uf-cpe-design-lab/kagu/prototype/drawing-sheet/out/layout/layout.pdf

# KAGU · INSTRUMENT CABINET — CHOSEN LAYOUT: 40" TALL · 600 mm DEEP · SPACED (1:8)

Two Rigol sets side by side in the low bay; drawers above. Dimensions in mm (inches). Drawer heights in gridfinity units (U = 7 mm).

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
72 (2.9") | 6U sensors, boxed boards | 12×10 / 12×12
72 (2.9") | 6U sensors, boxed boards | 12×10 / 12×12
72 (2.9") | 6U sensors, boxed boards | 12×10 / 12×12
72 (2.9") | 6U sensors, boxed boards | 12×10 / 12×12
72 (2.9") | 6U sensors, boxed boards | 12×10 / 12×12
72 (2.9") | 6U sensors, boxed boards | 12×10 / 12×12
72 (2.9") | 6U sensors, boxed boards | 12×10 / 12×12
10U stacked boxes, tools | 12×10 / 12×12 | 103 (4.1")
10U stacked boxes, tools | 12×10 / 12×12 | 103 (4.1")
6U sensors, boxed boards | 12×10 / 12×12 | 75 (3.0")
6U sensors, boxed boards | 12×10 / 12×12 | 75 (3.0")
6U sensors, boxed boards | 12×10 / 12×12 | 75 (3.0")
6U sensors, boxed boards | 12×10 / 12×12 | 75 (3.0")

worktop 1016 (40")

fence 1091 (43.0")

bay 300 (11.8")

1200 (47.2")

# 40" · SPACED — FRONT — 13 DRAWERS

spare height shared out as taller fronts · drawers 12 + 12 units wide × 10 deep (500) / 12 deep (600)

worktop (between the sides)

2 printed M6 handles per side, 180 mm centres (Emkatech, CC BY-NC)

printed wall standoffs 50 (2"): PETG cone + TPU cap

600 (23.6")

worktop 1016 (40")

fence +75 (3")

R50 (2.0")

FRONT

# RIGHT SIDE

BACK

### sides + back rise above the worktop; only the front corner is rounded

Pitch per drawer = bottom 12 + baseplate 5 + bin 7·U + lip 4.4 + clearance 4 + gap 3: 3U ≈ 49 (1.9") · 4U ≈ 56 (2.2") · 6U ≈ 70 (2.8") · 10U ≈ 98 (3.9").
6U: sensors (several per bin) and boxed boards one layer deep (3×2 bins, e.g. Raspberry Pi 5 boxes). 10U: boxed boards stacked two high, hand tools in Shadow Bins. Depth: 500 mm (19.7") → 18" slides, drawers 12 × 10 units; 600 mm (23.6") → 22" slides, 12 × 12 units (+20%). Drawers 12 units (21") wide on standard 1/2" slides.
