uf-cpe-design-lab/kagu/prototype/drawing-sheet/out/layout/layout.png

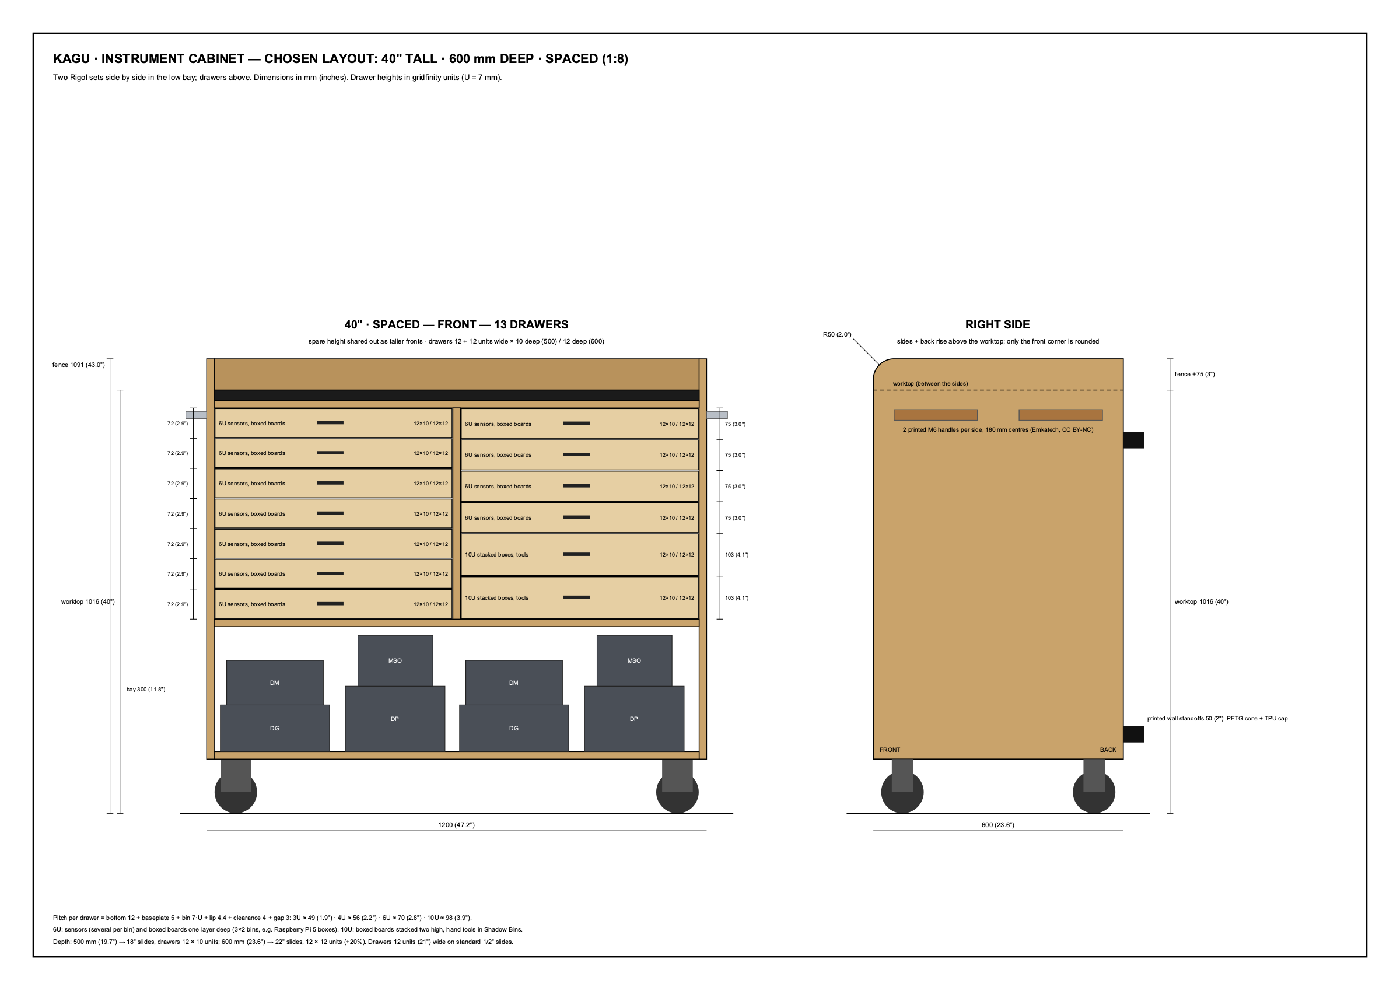
prototype/drawing-sheet/out/layout/layout.png
