uf-cpe-design-lab/kagu/prototype/drawing-sheet/out/layout/pull_preview.png

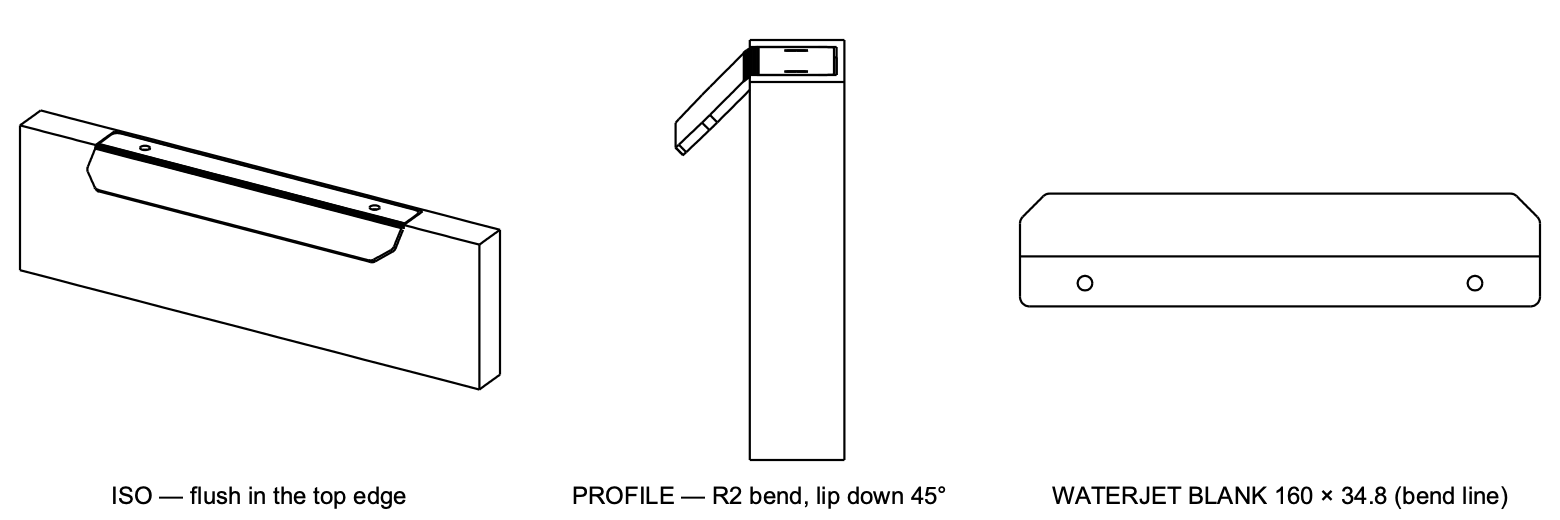
prototype/drawing-sheet/out/layout/pull_preview.png
