uf-cpe-design-lab/kagu/prototype/drawing-sheet/out/sheet1_notation.png

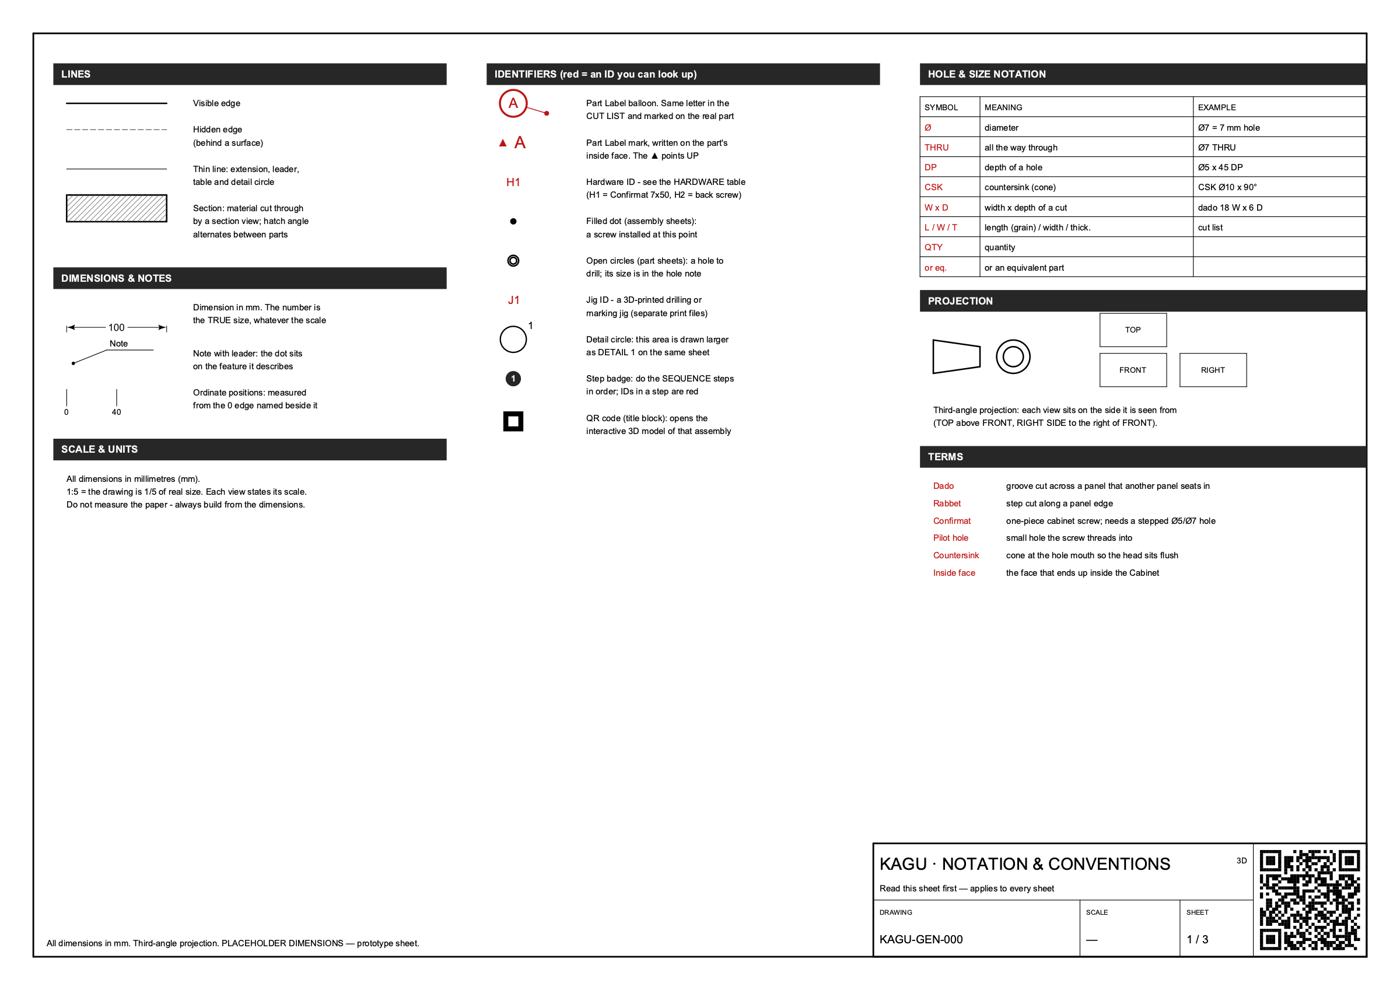
prototype/drawing-sheet/out/sheet1_notation.png
