uf-cpe-design-lab/kagu/prototype/drawing-sheet/out/sheet3_part_A.png

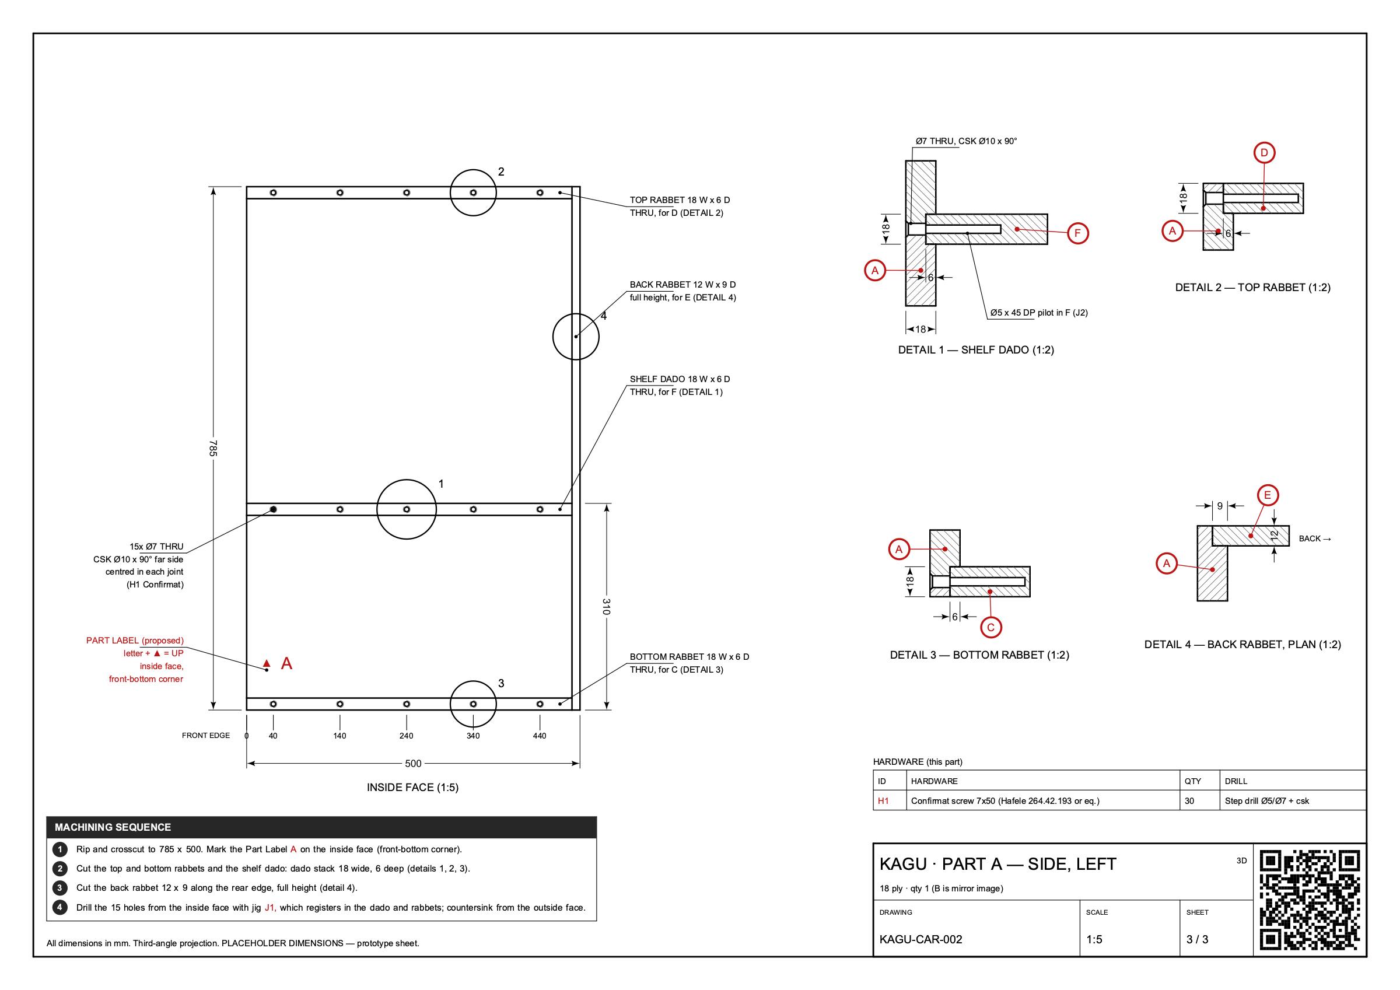
prototype/drawing-sheet/out/sheet3_part_A.png
