uf-cpe-design-lab/kagu/prototype/drawing-sheet/out/print/drawer_pull_flat_5052_2mm_waterjet.dxf

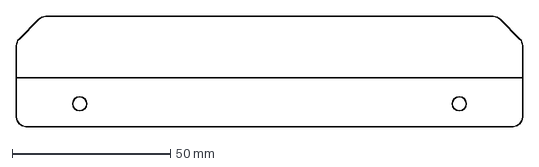
[picture p5: CAD file, 2026-11-09]
prototype/drawing-sheet/out/print/drawer_pull_flat_5052_2mm_waterjet.dxf
160.0 x 34.8 mm
