uf-cpe-design-lab/kagu/prototype/drawing-sheet/out/print/standoff_base_PETG.stl

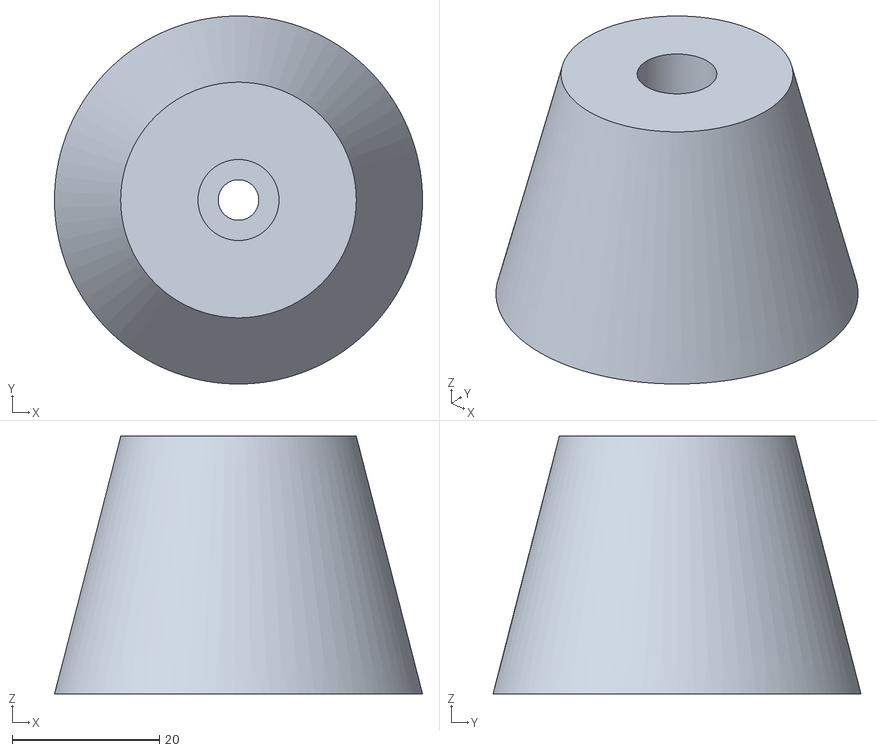
[picture p7: CAD file, 2026-11-09]
prototype/drawing-sheet/out/print/standoff_base_PETG.stl
50.0 x 50.0 x 35.0
