uf-cpe-design-lab/kagu/prototype/drawing-sheet/out/print/bin_1x1_6U_sensor.stl

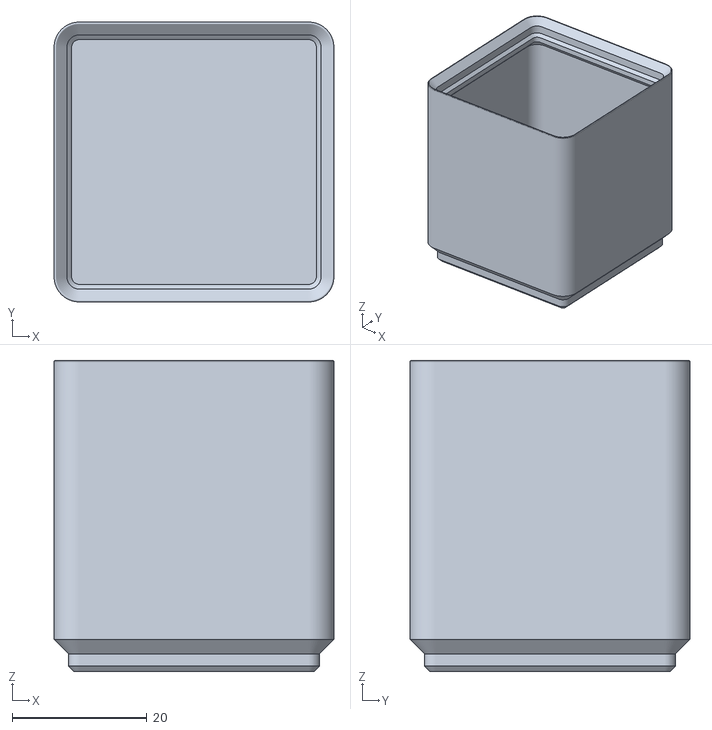
[picture p8: CAD file, 2026-11-09]
prototype/drawing-sheet/out/print/bin_1x1_6U_sensor.stl
41.5 x 41.5 x 46.1
