uf-cpe-design-lab/kagu/prototype/drawing-sheet/out/print/bin_3x2_10U_pi-box-stack.stl

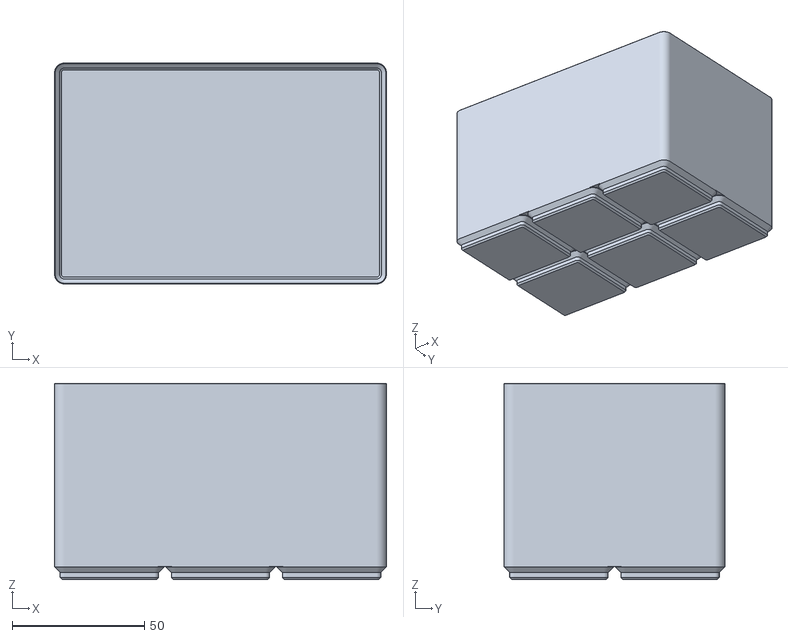
[picture p9: CAD file, 2026-11-09]
prototype/drawing-sheet/out/print/bin_3x2_10U_pi-box-stack.stl
125.5 x 83.5 x 74.1
