uf-cpe-design-lab/kagu/prototype/drawing-sheet/out/print/bin_3x2_6U_pi-box.stl

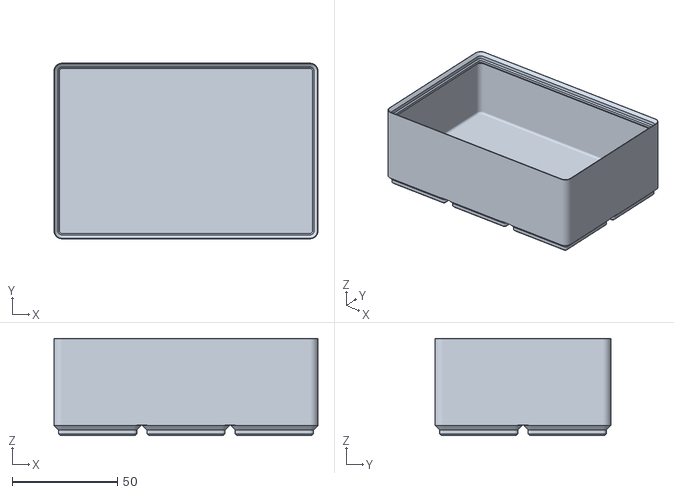
[picture p10: CAD file, 2026-11-09]
prototype/drawing-sheet/out/print/bin_3x2_6U_pi-box.stl
125.5 x 83.5 x 46.1
