uf-cpe-design-lab/kagu/prototype/drawing-sheet/out/print/handle_300_PETG.stl

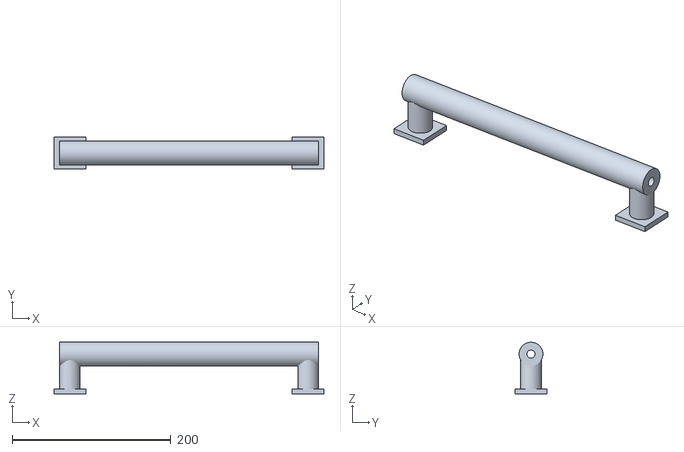
[picture p11: CAD file, 2026-11-09]
prototype/drawing-sheet/out/print/handle_300_PETG.stl
340.0 x 40.0 x 65.0
