uf-cpe-design-lab/kagu/prototype/drawing-sheet/out/print/bin_2x2_6U_sensor.stl

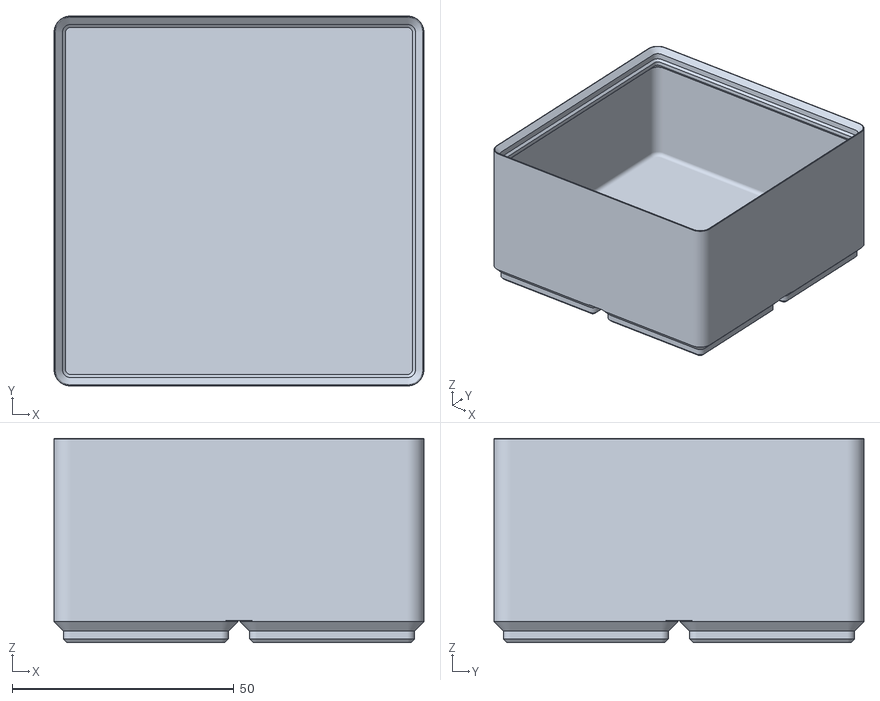
[picture p12: CAD file, 2026-11-09]
prototype/drawing-sheet/out/print/bin_2x2_6U_sensor.stl
83.5 x 83.5 x 46.1
