uf-cpe-design-lab/kagu/prototype/drawing-sheet/out/print/drawer_pull_ref.stl

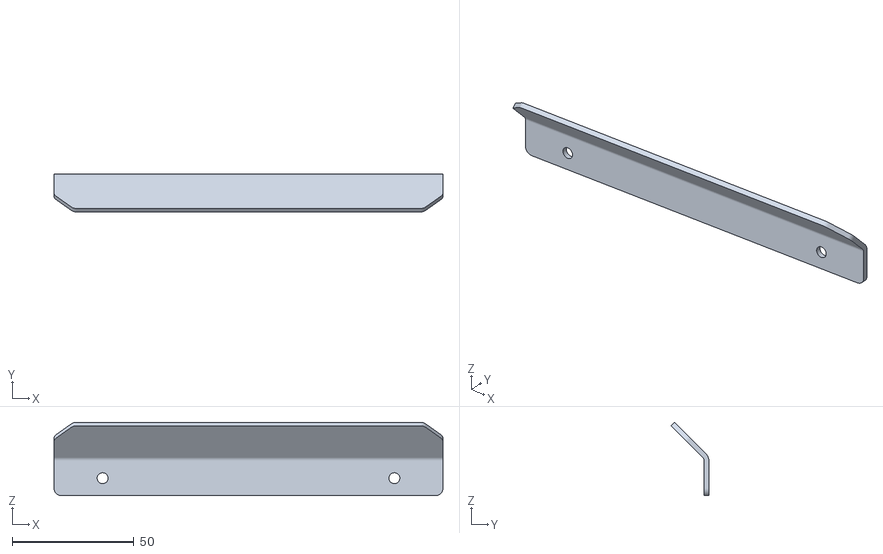
[picture p13: CAD file, 2026-11-09]
prototype/drawing-sheet/out/print/drawer_pull_ref.stl
160.0 x 15.6 x 30.1
