uf-cpe-design-lab/kagu/prototype/drawing-sheet/out/print/baseplate_5x2.stl

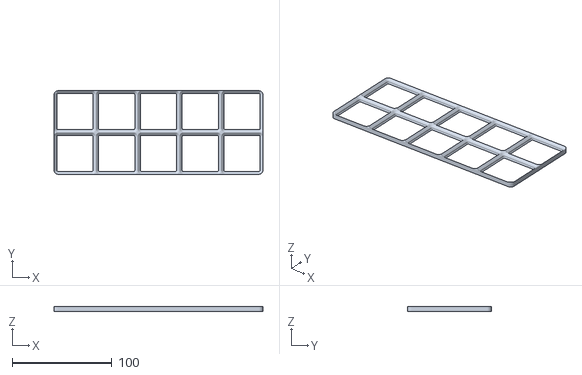
[picture p14: CAD file, 2026-11-09]
prototype/drawing-sheet/out/print/baseplate_5x2.stl
210.0 x 84.0 x 4.65
