uf-cpe-design-lab/kagu/prototype/drawing-sheet/out/print/standoff_cap_TPU.stl

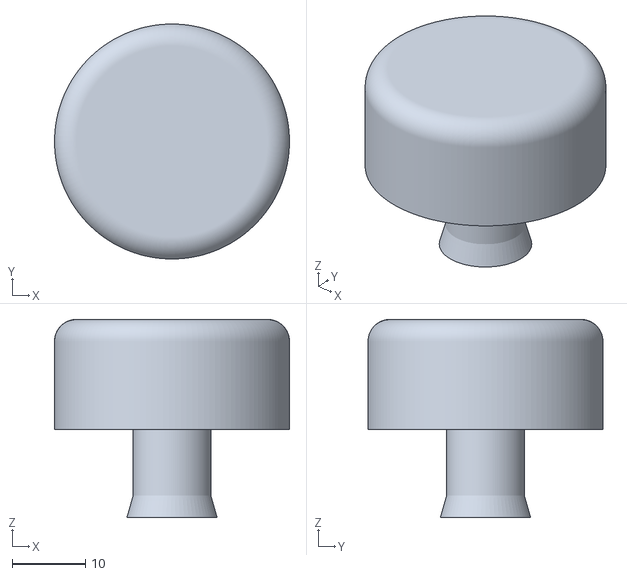
[picture p15: CAD file, 2026-11-09]
prototype/drawing-sheet/out/print/standoff_cap_TPU.stl
32.0 x 32.0 x 27.0
