uf-cpe-design-lab/kagu/prototype/drawing-sheet/out/print/bin_2x1_3U_flat.stl

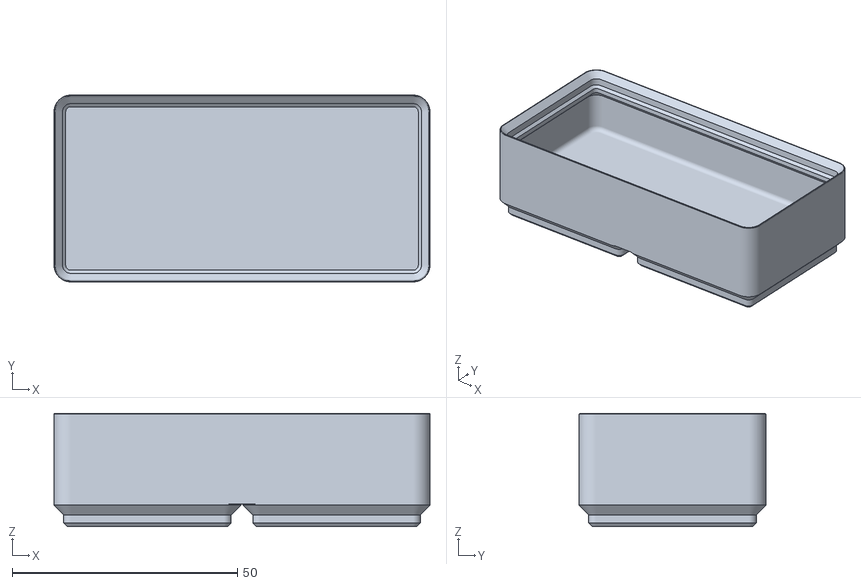
[picture p16: CAD file, 2026-11-09]
prototype/drawing-sheet/out/print/bin_2x1_3U_flat.stl
83.5 x 41.5 x 25.1
