uf-cpe-design-lab/kagu/prototype/drawing-sheet/out/sheet2_assembly.png

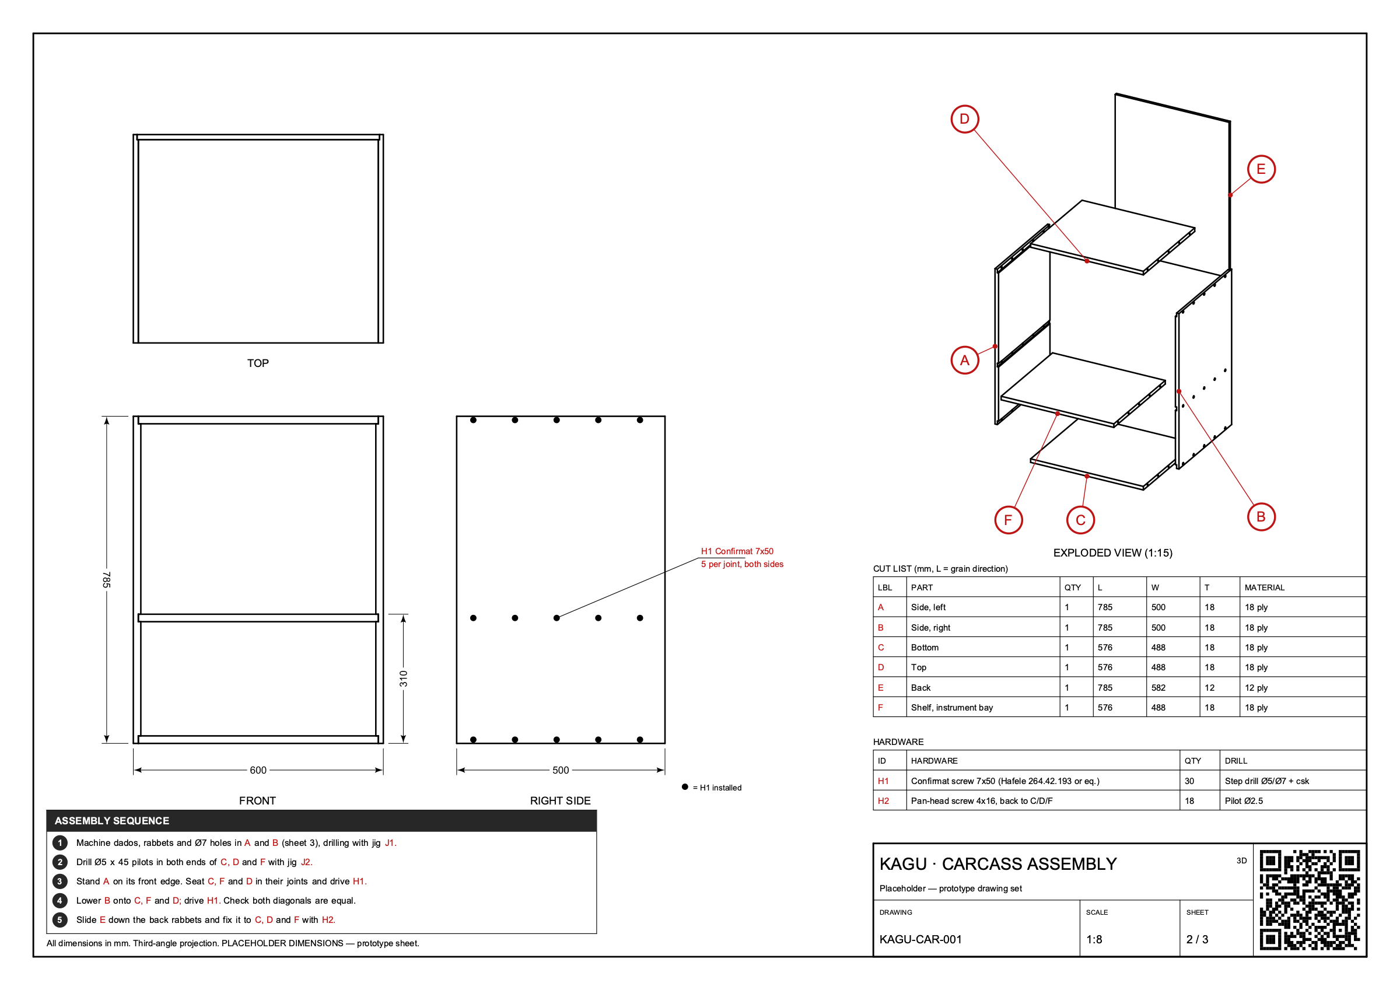
prototype/drawing-sheet/out/sheet2_assembly.png
