uf-cpe-design-lab/kagu/prototype/drawing-sheet/out/carcass_set.pdf

# KAGU · NOTATION & CONVENTIONS 3D Read this sheet first — applies to every sheet

DRAWING KAGU-GEN-000 | SCALE — | SHEET

All dimensions in mm. Third-angle projection. PLACEHOLDER DIMENSIONS — prototype sheet.

### LINES

Visible edge

Hidden edge
(behind a surface)

Thin line: extension, leader, table and detail circle

Section: material cut through by a section view; hatch angle alternates between parts

### DIMENSIONS & NOTES

Dimension in mm. The number is the TRUE size, whatever the scale

Note
Note with leader: the dot sits
on the feature it describes
0 | 40

Ordinate positions: measured from the 0 edge named beside it

### SCALE & UNITS

All dimensions in millimetres (mm).
1:5 = the drawing is 1/5 of real size. Each view states its scale. Do not measure the paper - always build from the dimensions.

### IDENTIFIERS (red = an ID you can look up)

A | Part Label balloon. Same letter in the CUT LIST and marked on the real part
▲ A | Part Label mark, written on the part's inside face. The ▲ points UP
H1 | Hardware ID - see the HARDWARE table (H1 = Confirmat 7x50, H2 = back screw)
| Filled dot (assembly sheets): a screw installed at this point
| Open circles (part sheets): a hole to drill; its size is in the hole note
J1 | Jig ID - a 3D-printed drilling or marking jig (separate print files)

1
| Detail circle: this area is drawn larger as DETAIL 1 on the same sheet

### 1 Step badge: do the SEQUENCE steps

| in order; IDs in a step are red
| QR code (title block): opens the interactive 3D model of that assembly

### HOLE & SIZE NOTATION

SYMBOL | MEANING | EXAMPLE
Ø | diameter | Ø7 = 7 mm hole
THRU | all the way through | Ø7 THRU
DP | depth of a hole | Ø5 x 45 DP
CSK | countersink (cone) | CSK Ø10 x 90°
W x D | width x depth of a cut | dado 18 W x 6 D
L / W / T | length (grain) / width / thick. | cut list
QTY | quantity
or eq. | or an equivalent part

### PROJECTION

FRONT

TOP

RIGHT

Third-angle projection: each view sits on the side it is seen from (TOP above FRONT, RIGHT SIDE to the right of FRONT).

### TERMS

Dado | groove cut across a panel that another panel seats in
Rabbet | step cut along a panel edge
Confirmat | one-piece cabinet screw; needs a stepped Ø5/Ø7 hole
Pilot hole | small hole the screw threads into
Countersink | cone at the hole mouth so the head sits flush
Inside face | the face that ends up inside the Cabinet

D

E

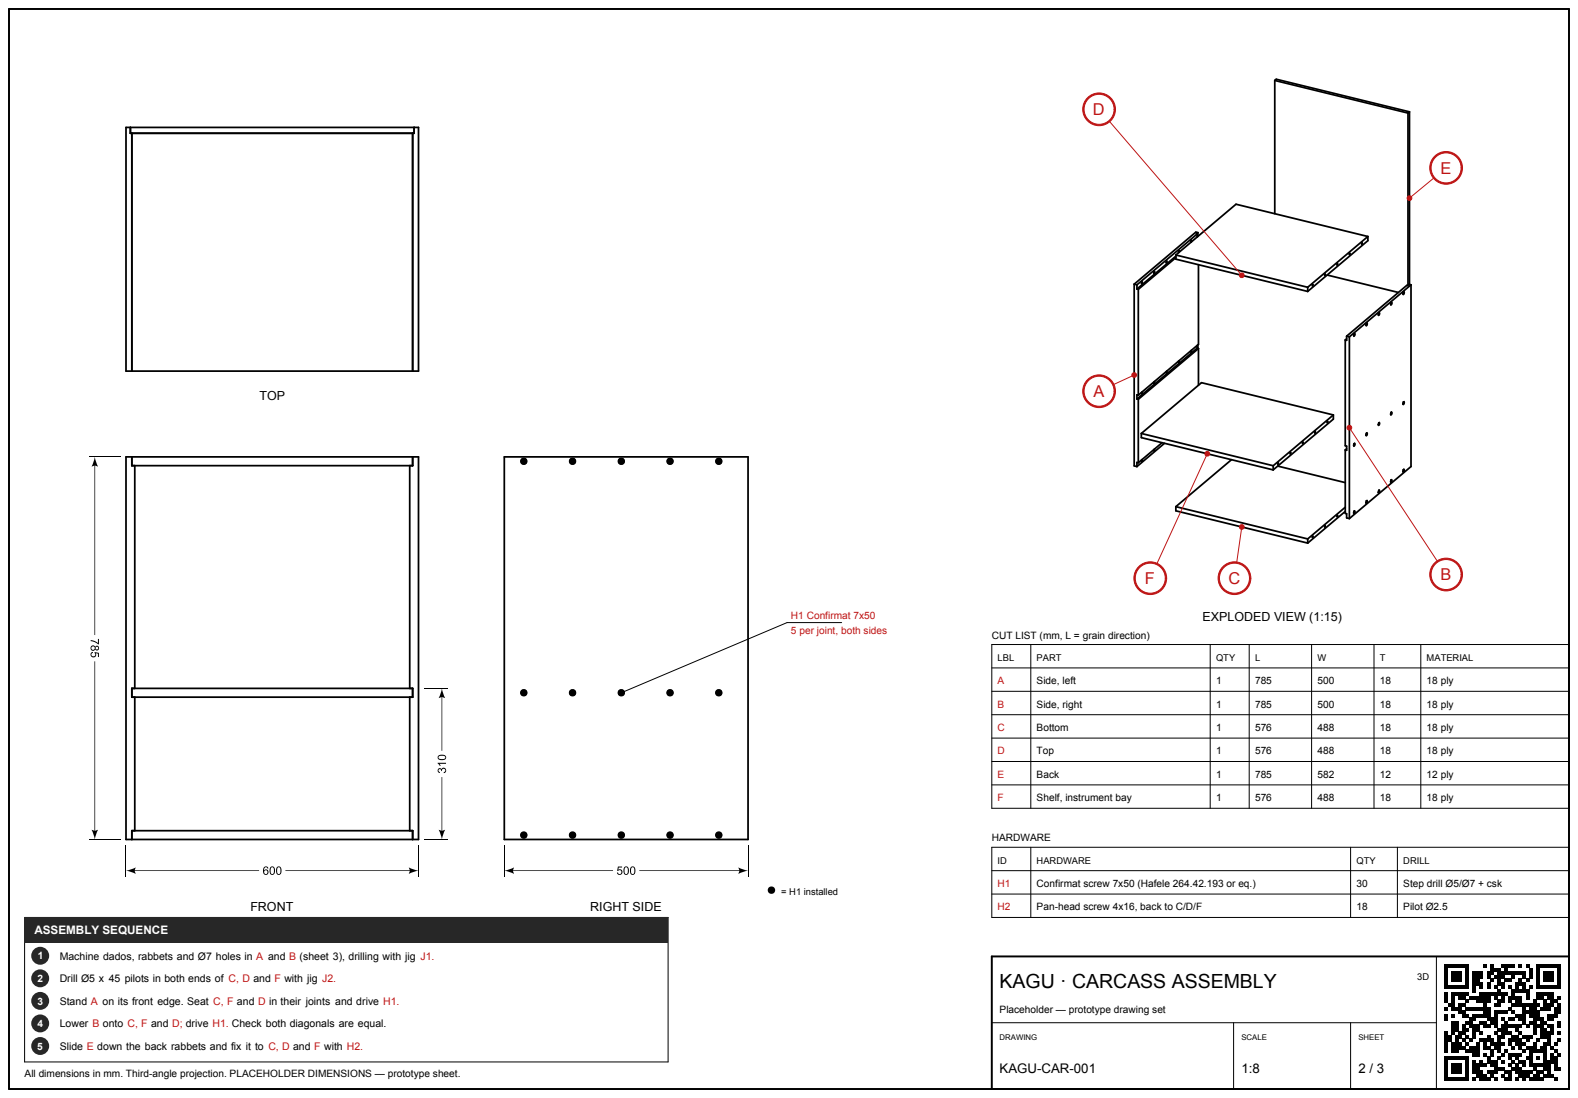
[picture p18: page 2]
FRONT; RIGHT SIDE; TOP; = H1 installed; EXPLODED VIEW (1:15); HARDWARE; ASSEMBLY SEQUENCE

H1 Confirmat 7x50
5 per joint, both sides

CUT LIST (mm, L = grain direction)

LBL | PART | QTY | L | W | T | MATERIAL

A | Side, left | 1 | 785 | 500 | 18 | 18 ply

B | Side, right | 1 | 785 | 500 | 18 | 18 ply

C | Bottom | 1 | 576 | 488 | 18 | 18 ply

D | Top | 1 | 576 | 488 | 18 | 18 ply

E | Back | 1 | 785 | 582 | 12 | 12 ply

F | Shelf, instrument bay | 1 | 576 | 488 | 18 | 18 ply

ID | HARDWARE | QTY | DRILL

H1 | Confirmat screw 7x50 (Hafele 264.42.193 or eq.) | 30 | Step drill Ø5/Ø7 + csk

H2 | Pan-head screw 4x16, back to C/D/F | 18 | Pilot Ø2.5

1 Machine dados, rabbets and Ø7 holes in A and B (sheet 3), drilling with jig J1.

2 Drill Ø5 x 45 pilots in both ends of C, D and F with jig J2.

KAGU · CARCASS ASSEMBLY 3D Placeholder — prototype drawing set

3 Stand A on its front edge. Seat C, F and D in their joints and drive H1.

4 Lower B onto C, F and D; drive H1. Check both diagonals are equal.

5 Slide E down the back rabbets and fix it to C, D and F with H2.

KAGU-CAR-001 | 1:8

2

F

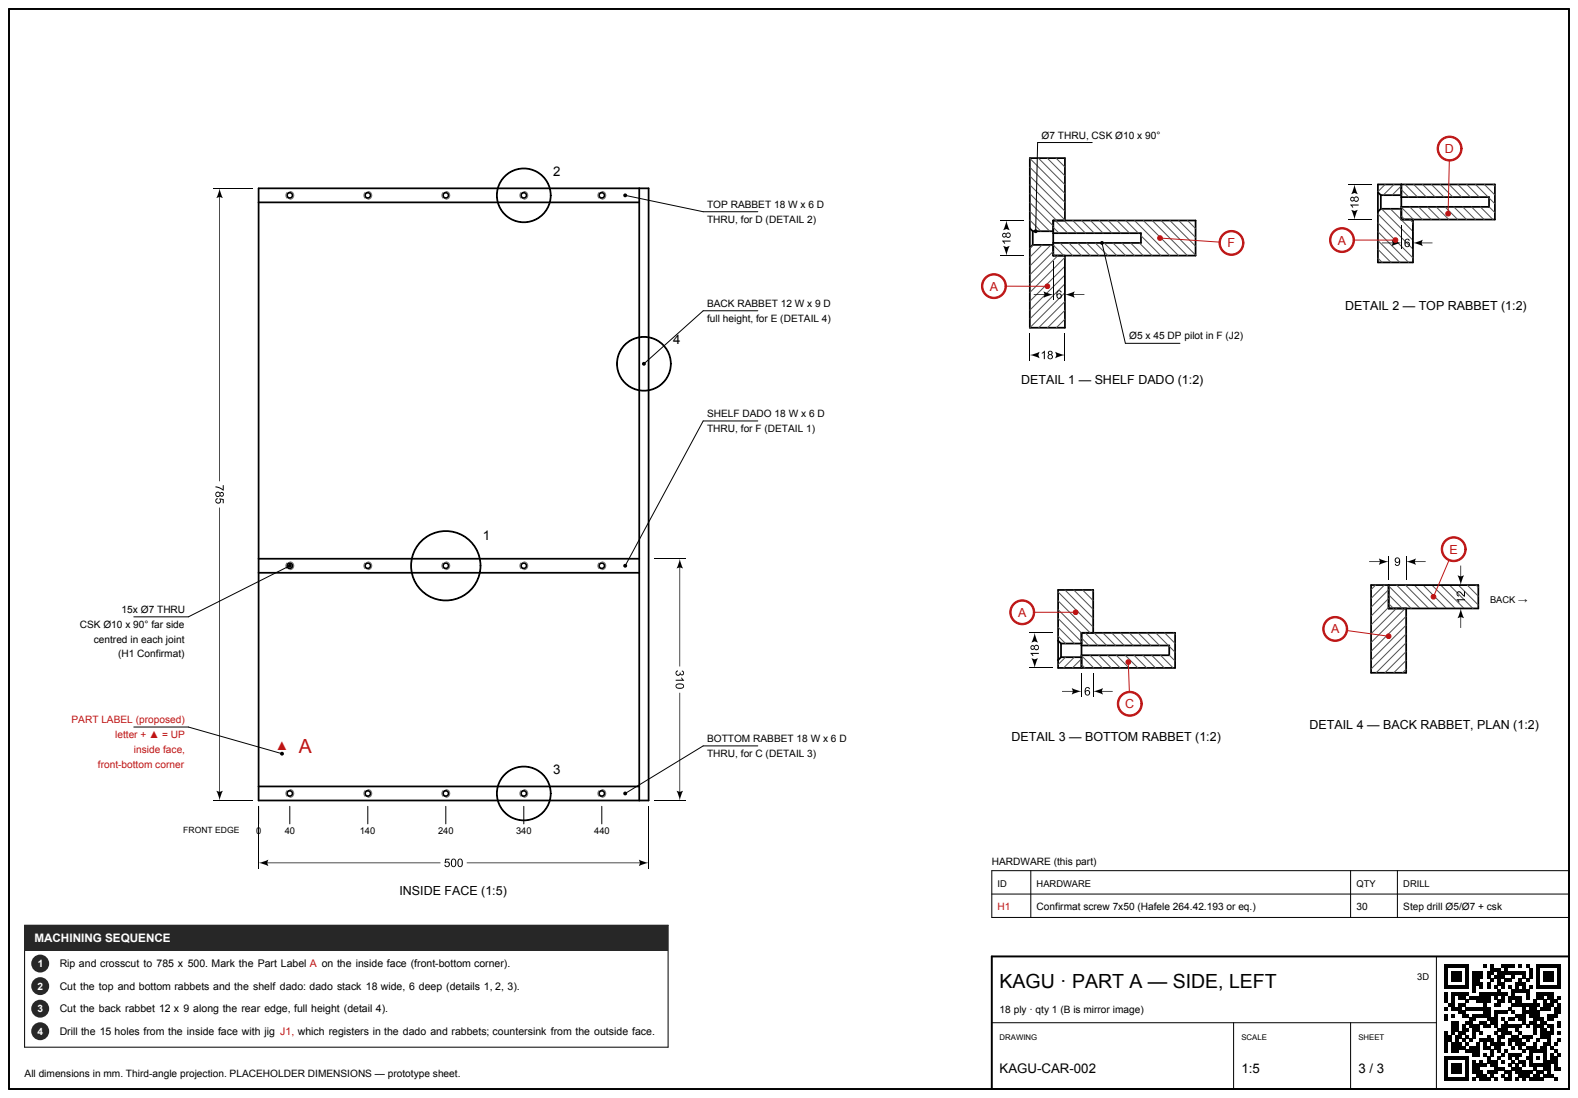
[picture p19: page 3]
INSIDE FACE (1:5); FRONT EDGE; 15x Ø7 THRU; letter + ▲ = UP inside face,; Ø7 THRU, CSK Ø10 x 90°; BACK →; MACHINING SEQUENCE

TOP RABBET 18 W x 6 D
THRU, for D (DETAIL 2)

BACK RABBET 12 W x 9 D
full height, for E (DETAIL 4)

DETAIL 2 — TOP RABBET (1:2)

Ø5 x 45 DP pilot in F (J2)

DETAIL 1 — SHELF DADO (1:2)

SHELF DADO 18 W x 6 D
THRU, for F (DETAIL 1)

CSK Ø10 x 90° far side
centred in each joint
(H1 Confirmat)

PART LABEL (proposed)

DETAIL 4 — BACK RABBET, PLAN (1:2)

BOTTOM RABBET 18 W x 6 D
THRU, for C (DETAIL 3)

DETAIL 3 — BOTTOM RABBET (1:2)

front-bottom corner

HARDWARE (this part)

ID | HARDWARE | QTY | DRILL

H1 | Confirmat screw 7x50 (Hafele 264.42.193 or eq.) | 30 | Step drill Ø5/Ø7 + csk

1 Rip and crosscut to 785 x 500. Mark the Part Label A on the inside face (front-bottom corner).

KAGU · PART A — SIDE, LEFT 3D 18 ply · qty 1 (B is mirror image)

2 Cut the top and bottom rabbets and the shelf dado: dado stack 18 wide, 6 deep (details 1, 2, 3).

3 Cut the back rabbet 12 x 9 along the rear edge, full height (detail 4).

4 Drill the 15 holes from the inside face with jig J1, which registers in the dado and rabbets; countersink from the outside face.

KAGU-CAR-002 | 1:5
