uf-cpe-design-lab/kagu/(commit log)

2026-11-09 Add drawing-sheet prototype: code-generated A3 shop drawing set
    Throwaway prototype for the CAD toolchain decision: build123d model ->
    notation sheet, assembly sheet and part sheet with section details,
    balloons, cut list, hardware table and step panels, as a vector PDF.
2026-11-09 Add layout prototype, printable parts and pull waterjet blank
    Chosen layout (40" worktop, 600 mm deep, two drawer columns) with interactive
    3D viewer, gridfinity test bins, printed wall standoffs and the bent aluminium
    drawer-pull flat pattern for waterjet cutting.
    [baseplate_5x2.stl, bin_1x1_6U_sensor.stl, bin_2x1_3U_flat.stl, bin_2x1_6U_sensor.stl, bin_2x2_6U_sensor.stl, bin_3x2_10U_pi-box-stack.stl, bin_3x2_6U_pi-box.stl, drawer_pull_flat_5052_2mm_waterjet.dxf]
2026-11-10 Prototype: whole-Cabinet lock and interlock variants on the chosen layout
2026-11-10 Lock prototype: find Drawer front meshes inside groups, measure in the Cabinet frame
2026-11-10 Lock prototype: real CompX groove/lock-hole positions, show slides; add CompX findings
2026-11-10 Prototype: Locked Drawer Viewing Lid variants on the chosen layout
    Three lid styles (hinged, tilt-out, slide-out) and two Key B locks on
    the 40" · 600 deep layout, with live fit checks: lid clearance to the
    fronts above at full extension, Bin rows kept, room behind the front for
    the lock and an e-lock provision, pitch per Locked Drawer, lid sag.
2026-11-10 Lid prototype: drop-in sheet in rabbets + grooved rear rail; no-lock option with the lock reserved
2026-11-10 Lid prototype: drop-in sheet rests on sides and back only, finger hole, no lock
2026-11-10 Lid prototype: cut a real finger hole through the sheet; add a close-up view
